q1375854021/AD9854_Driver_Board_BlueTooth/Firmware/Core/Src/main.c

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
/* Includes ------------------------------------------------------------------*/
#include "main.h"
#include "tim.h"
#include "usart.h"
#include "gpio.h"

/* USER CODE BEGIN Includes */
#include "Led.h"
#include "Usart1.h"
#include "AD9854.h"

/* USER CODE END Includes */


void SystemClock_Config(void);
/**
  * @brief  The application entry point.
  * @retval int
  */
int main(void)
{
  /* USER CODE BEGIN 1 */
	struct Uart_Data_Struc Uart_Data_AD9854;
  /* USER CODE END 1 */

  /* MCU Configuration--------------------------------------------------------*/

  /* Reset of all peripherals, Initializes the Flash interface and the Systick. */
  LL_APB2_GRP1_EnableClock(LL_APB2_GRP1_PERIPH_AFIO);
  LL_APB1_GRP1_EnableClock(LL_APB1_GRP1_PERIPH_PWR);

  /* System interrupt init*/
  NVIC_SetPriorityGrouping(NVIC_PRIORITYGROUP_2);

  /* SysTick_IRQn interrupt configuration */
  NVIC_SetPriority(SysTick_IRQn, NVIC_EncodePriority(NVIC_GetPriorityGrouping(),1, 1));

  /** NOJTAG: JTAG-DP Disabled and SW-DP Enabled
  */
  LL_GPIO_AF_Remap_SWJ_NOJTAG();

  /* Configure the system clock */
  SystemClock_Config();

  /* Initialize all configured peripherals */
  MX_GPIO_Init();
  MX_TIM1_Init();
  MX_USART1_UART_Init();
  /* USER CODE BEGIN 2 */
	AD9854_Init();                //AD9854配置初始化
	AD9854_SetSine(1000000,4095);      //默认输出1MHz满幅正弦波
  /* USER CODE END 2 */

  /* Infinite loop */
  /* USER CODE BEGIN WHILE */
  while (1)
  {
		if(AD9854_Uartdata_Analysis(&Uart_Data_AD9854)!=0)           //AD9854的串口接收数据提取
		{
			USART1_Printf("Error\r\n");
		}
		USART1_Recv_DataArray_Clear();                          //清空串口缓冲区数据
		AD9854_Cmd_Execute(&Uart_Data_AD9854);                  //根据接收到的数据执行对应命令
		LED_Toggle();
		LL_mDelay(1000);
    /* USER CODE END WHILE */

    /* USER CODE BEGIN 3 */
  }
  /* USER CODE END 3 */
}

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
