q1375854021/AD9854_Driver_Board_BlueTooth/Firmware/Core/Inc/main.h

#define LED_Pin LL_GPIO_PIN_13
#define LED_GPIO_Port GPIOC
#define AD9854_RD_Pin LL_GPIO_PIN_0
#define AD9854_RD_GPIO_Port GPIOB
#define AD9854_OSK_Pin LL_GPIO_PIN_1
#define AD9854_OSK_GPIO_Port GPIOB
#define AD9854_FSK_Pin LL_GPIO_PIN_11
#define AD9854_FSK_GPIO_Port GPIOB
#define AD9854_RST_Pin LL_GPIO_PIN_11
#define AD9854_RST_GPIO_Port GPIOA
#define AD9854_UCLK_Pin LL_GPIO_PIN_12
#define AD9854_UCLK_GPIO_Port GPIOA
#define AD9854_WR_Pin LL_GPIO_PIN_15
#define AD9854_WR_GPIO_Port GPIOA
#define NVIC_PRIORITYGROUP_0         ((uint32_t)0x00000007) /*!< 0 bit  for pre-emption priority,
#define NVIC_PRIORITYGROUP_1         ((uint32_t)0x00000006) /*!< 1 bit  for pre-emption priority,
#define NVIC_PRIORITYGROUP_2         ((uint32_t)0x00000005) /*!< 2 bits for pre-emption priority,
#define NVIC_PRIORITYGROUP_3         ((uint32_t)0x00000004) /*!< 3 bits for pre-emption priority,
#define NVIC_PRIORITYGROUP_4         ((uint32_t)0x00000003) /*!< 4 bits for pre-emption priority,
