q1375854021/AD9854_Driver_Board_BlueTooth/Firmware/Core/Src/AD9854.c

//=====================================================================
//                    AD9854 驱动程序设计

//AD9854.c
//康威电子工作室
//说明：本程序基于硬件的外接晶振为20MHZ
//=====================================================================

#include "AD9854.h"      //STC单片机头文件	
#include "Usart1.h"


uchar FreqWord[6];				 //6个字节频率控制字

//**********************以下为系统时钟以及其相关变量设置**************************

/* 
      此处根据自己的需要设置系统时钟以及与其相关的因子，一次需且只需开启一个   
      CLK_Set为时钟倍频设置，可设置4~20倍倍频，但最大不能超过300MHZ
      Freq_mult_ulong和Freq_mult_doulle均为2的48次方除以系统时钟，一个为长整形，一个为双精度型
*/

/*
#define      CLK_Set            4
const ulong  Freq_mult_ulong  = 3518437;
const double Freq_mult_doulle = 3518437.2088832;
*/

/*
#define      CLK_Set            5
const ulong  Freq_mult_ulong  = 2814750;
const double Freq_mult_doulle = 2814749.76710656;
*/

 /*
#define      CLK_Set            6
const ulong  Freq_mult_ulong  = 2345625;
const double Freq_mult_doulle = 2345624.80592213;
  */

/*
#define      CLK_Set            7
const ulong  Freq_mult_ulong  = 2010536;
const double Freq_mult_doulle = 2010535.54793326;
*/

/*
#define      CLK_Set            8
const ulong  Freq_mult_ulong  = 1759219;
const double Freq_mult_doulle = 1759218.6044416;
*/

/*
#define      CLK_Set            9
const ulong  Freq_mult_ulong  = 1563750;
const double Freq_mult_doulle = 1563749.87061476;
*/

/*
#define      CLK_Set            10
const ulong  Freq_mult_ulong  = 1407375;
const double Freq_mult_doulle = 1407374.88355328;
*/

/*
#define      CLK_Set            11
const ulong  Freq_mult_ulong  = 1279432;
const double Freq_mult_doulle = 1279431.712321164;
*/


#define      CLK_Set            0x4C   //0x0C 
const ulong  Freq_mult_ulong  = 1172812;
const double Freq_mult_doulle = 1172812.402961067;


/*
#define      CLK_Set            13
const ulong  Freq_mult_ulong  = 1082596;
const double Freq_mult_doulle = 1082596.064271754;
*/

/*
#define      CLK_Set            14
const ulong  Freq_mult_ulong  = 1005268;
const double Freq_mult_doulle = 1005267.773966629;
*/

/*
#define      CLK_Set            15
const ulong  Freq_mult_ulong  = 938250;
const double Freq_mult_doulle = 938249.9223688533;

 */
//**************************修改硬件时要修改的部分********************************



//**************************以下部分为函数定义********************************

static void AD9854_WR_Byte(u8 addr,u8 dat);				  
static void Freq_convert(long Freq);	         	  
extern void AD9854_SetSine(ulong Freq,uint Shape);	  
static void Freq_double_convert(double Freq);		  
extern void AD9854_SetSine_double(double Freq,uint Shape);
extern void AD9854_InitFSK(void);				
extern void AD9854_SetFSK(ulong Freq1,ulong Freq2);					  
extern void AD9854_InitBPSK(void);					  
extern void AD9854_SetBPSK(uint Phase1,uint Phase2);					
extern void AD9854_InitOSK(void);					 
extern void AD9854_SetOSK(uchar RateShape);					  
extern void AD9854_InitAM(void);					 
extern void AD9854_SetAM(uint Shape);					
extern void AD9854_InitRFSK(void);					 
extern void AD9854_SetRFSK(ulong Freq_Low,ulong Freq_High,ulong Freq_Up_Down,ulong FreRate);				


//====================================================================================
//函数名称:void AD9854_WR_Byte(uchar addr,uchar dat)
//函数功能:AD9854并行口写入数据
//入口参数:addr     6位地址
//         dat      写入的数据
//出口参数:无
//====================================================================================
	u32 dat1,dat2;

void AD9854_WR_Byte(u8 addr,u8 dat)
{   //为了配置PA0~PA7而不改变其它引脚状态，应当把BSRR的第16~23位置1，从而清零低八位，然后在把第八位重新配置一下就可以了
	AD9854_DataBus |= 0x00FF0000;               //清除PA0~PA7
	AD9854_DataBus |= dat;
	AD9854_AdrBus |= 0x01F80000;                       //清除PB3~PB8    //0000 0001 1111 1000
	AD9854_AdrBus |= addr << 3;                         //低6位  0~5 -> 3~8
	AD9854_WR      = 0;                         //然后WR上给一个脉冲，传送数据到AD9854的Buffer
	AD9854_WR      = 1;
}

//====================================================================================
//函数名称:void AD9854_Init(void)
//函数功能:AD9854初始化
//入口参数:无
//出口参数:无
// 具体初始状态可见AD9854手册的Figure35
//====================================================================================
void AD9854_Init(void)
{
	AD9854_WR=1;                  //将读、写控制端口设为无效
	AD9854_RD=1;
	AD9854_UDCLK=0;
	AD9854_RST=1;                 //复位AD9854
	AD9854_RST=0;

	AD9854_WR_Byte(0x1d,0x00);					//打开比较器供电开关，QDAC供电开关，DAC供电开关，数字供电开关。
	//	AD9854_WR_Byte(0x1d,0x10);	    //关闭比较器
	AD9854_WR_Byte(0x1e,CLK_Set);	   		//设置系统时钟倍频        0C  0000_1100      倍频01100，就是12倍倍频，240MHz，不过已经超过200MHz了，PLL range bit应当为1，也就是应当设置为0100_1100 应当是4C
	AD9854_WR_Byte(0x1f,0x00);	   			//设置系统为模式0，由外部更新     ACC1 AC2 Triangle SRC_QADC都没有用到
	AD9854_WR_Byte(0x20,0x60);	   			//设置为可调节幅度，取消插值补偿     //0110_0000   内部逆sinc滤波器旁路掉了，然后OSK EN设为一，可以控制幅度  最后其实可以做一下逆sinc滤波的

	AD9854_UDCLK=1;               			//更新AD9854输出
	AD9854_UDCLK=0;
}
//====================================================================================
//函数名称:void Freq_convert(long Freq)
//函数功能:正弦信号频率数据转换
//入口参数:Freq   需要转换的频率，取值从0~SYSCLK/2
//出口参数:无   但是影响全局变量FreqWord[6]的值
//说明：   该算法位多字节相乘算法，有公式FTW = (Desired Output Frequency × 2N)/SYSCLK
//         得到该算法，其中N=48，Desired Output Frequency 为所需要的频率，即Freq，SYSCLK
//         为可编程的系统时钟，FTW为48Bit的频率控制字，即FreqWord[6]
//====================================================================================
void Freq_convert(long Freq)   
{
	ulong FreqBuf;
	ulong Temp=Freq_mult_ulong;   	       

	uchar Array_Freq[4];			     //将输入频率因子分为四个字节
	Array_Freq[0]=(uchar)Freq;
	Array_Freq[1]=(uchar)(Freq>>8);
	Array_Freq[2]=(uchar)(Freq>>16);
	Array_Freq[3]=(uchar)(Freq>>24);

	FreqBuf=Temp*Array_Freq[0];                  
	FreqWord[0]=FreqBuf;    
	FreqBuf>>=8;

	FreqBuf+=(Temp*Array_Freq[1]);
	FreqWord[1]=FreqBuf;
	FreqBuf>>=8;

	FreqBuf+=(Temp*Array_Freq[2]);
	FreqWord[2]=FreqBuf;
	FreqBuf>>=8;

	FreqBuf+=(Temp*Array_Freq[3]);
	FreqWord[3]=FreqBuf;
	FreqBuf>>=8;

	FreqWord[4]=FreqBuf;
  FreqWord[5]=FreqBuf>>8;			
}  

//====================================================================================
//函数名称:void AD9854_SetSine(ulong Freq,uint Shape)
//函数功能:AD9854正弦波产生程序
//入口参数:Freq   频率设置，取值范围为0~(1/2)*SYSCLK
//         Shape  幅度设置. 为12 Bit,取值范围为(0~4095) ,取值越大,幅度越大 
//出口参数:无
//====================================================================================
void AD9854_SetSine(ulong Freq,uint Shape)
{
	uchar count;
	uchar Adress;

	Adress = 0x04;                        //选择频率控制字地址的初值

	Freq_convert(Freq);		           //频率转换

	for(count=6;count>0;)	          //写入6字节的频率控制字  
	{
		AD9854_WR_Byte(Adress++,FreqWord[--count]);   //写入频率FTW1
	}

	AD9854_WR_Byte(0x21,Shape>>8);	  //设置I通道幅度
	AD9854_WR_Byte(0x22,(uchar)(Shape&0xff));

	AD9854_WR_Byte(0x23,Shape>>8);	  //设置Q通道幅度
	AD9854_WR_Byte(0x24,(uchar)(Shape&0xff));

	AD9854_UDCLK=1;                    //更新AD9854输出
	AD9854_UDCLK=0;
}

//====================================================================================
//函数名称:void Freq_doublt_convert(double Freq)
//函数功能:正弦信号频率数据转换
//入口参数:Freq   需要转换的频率，取值从0~SYSCLK/2
//出口参数:无   但是影响全局变量FreqWord[6]的值
//说明：   有公式FTW = (Desired Output Frequency × 2N)/SYSCLK得到该函数，
//         其中N=48，Desired Output Frequency 为所需要的频率，即Freq，SYSCLK
//         为可编程的系统时钟，FTW为48Bit的频率控制字，即FreqWord[6]
//注意：   该函数与上面函数的区别为该函数的入口参数为double，可使信号的频率更精确
//         建议在100HZ以下用本函数，在高于100HZ的情况下用函数void Freq_convert(long Freq)
//====================================================================================
void Freq_double_convert(double Freq)   
{
	ulong Low32;
	uint  High16;
	double Temp=Freq_mult_doulle;   	            //23ca99为2的48次方除以120M
	Freq*=(double)(Temp);
	//	1 0000 0000 0000 0000 0000 0000 0000 0000 = 4294967295
	High16 =(int)(Freq/4294967295);                  //2^32 = 4294967295
	Freq -= (double)High16*4294967295;
	Low32 = (ulong)Freq;

	FreqWord[0]=Low32;	     
	FreqWord[1]=Low32>>8;
	FreqWord[2]=Low32>>16;
	FreqWord[3]=Low32>>24;
	FreqWord[4]=High16;
	FreqWord[5]=High16>>8;			
} 
//====================================================================================
//函数名称:void AD9854_SetSine_double(double Freq,uint Shape)
//函数功能:AD9854正弦波产生程序
//入口参数:Freq   频率设置，取值范围为0~1/2*SYSCLK
//         Shape  幅度设置. 为12 Bit,取值范围为(0~4095) 
//出口参数:无
//====================================================================================
void AD9854_SetSine_double(double Freq,uint Shape)
{
	uchar count=0;
	uchar Adress;

	Adress=0x04;						     //选择频率控制字1地址的初值

	Freq_double_convert(Freq);		           //频率转换

	for(count=6;count>0;)	                    //写入6字节的频率控制字  
	{
		AD9854_WR_Byte(Adress++,FreqWord[--count]);
	}

	AD9854_WR_Byte(0x21,Shape>>8);	  //设置I通道幅度
	AD9854_WR_Byte(0x22,(uchar)(Shape&0xff));

	AD9854_WR_Byte(0x23,Shape>>8);	  //设置Q通道幅度
	AD9854_WR_Byte(0x24,(uchar)(Shape&0xff));

	AD9854_UDCLK=1;                    //更新AD9854输出
	AD9854_UDCLK=0;
}

//====================================================================================
//函数名称:void AD9854_InitFSK(void)
//函数功能:AD9854的FSK初始化
//入口参数:无
//出口参数:无
// 仅仅是初始化了FSK而已，还没有配置FSK的FTW1和FTW2。
//====================================================================================
void AD9854_InitFSK(void)
{
	AD9854_WR=1;                        //将读、写控制端口设为无效
	AD9854_RD=1;
	AD9854_UDCLK=0;
	AD9854_RST=1;                        //复位AD9854
	AD9854_RST=0;	

	AD9854_WR_Byte(0x1d,0x00);	       //打开比较器   
	AD9854_WR_Byte(0x1e,CLK_Set);	   //设置系统时钟倍频  
	AD9854_WR_Byte(0x1f,0x02);	       //设置系统为模式1，由外部更新   
	AD9854_WR_Byte(0x20,0x60);	      //设置为可调节幅度，取消插值补偿  

	AD9854_UDCLK=1;                  //更新AD9854输出
	AD9854_UDCLK=0;
}

//====================================================================================
//函数名称:void AD9854_SetFSK(ulong Freq1,ulong Freq2)
//函数功能:AD9854的FSK设置
//入口参数:Freq1   FSK频率1
//         Freq2   FSK频率2
//出口参数:无
// 这里Freq1必须小于Freq2
//====================================================================================
void AD9854_SetFSK(ulong Freq1,ulong Freq2)
{
	uchar count=6;
	uchar Adress1,Adress2;

	const uint Shape=4000;	      //幅度设置. 为12 Bit,取值范围为(0~4095)

	Adress1=0x04;				 //选择频率控制字1地址的初值
	Adress2=0x0a;				 //选择频率控制字2地址的初值

	Freq_convert(Freq1);               //频率转换1

	for(count=6;count>0;)	          //写入6字节的频率控制字  
	{
		AD9854_WR_Byte(Adress1++,FreqWord[--count]);
	}

	Freq_convert(Freq2);               //频率转换2

	for(count=6;count>0;)	          //写入6字节的频率控制字  
	{
		AD9854_WR_Byte(Adress2++,FreqWord[--count]);
	}

	AD9854_WR_Byte(0x21,Shape>>8);	      //设置I通道幅度
	AD9854_WR_Byte(0x22,(uchar)(Shape&0xff));

	AD9854_WR_Byte(0x23,Shape>>8);	     //设置Q通道幅度
	AD9854_WR_Byte(0x24,(uchar)(Shape&0xff));

	AD9854_UDCLK=1;                    //更新AD9854输出
	AD9854_UDCLK=0;		
}

//====================================================================================
//函数名称:void AD9854_InitBPSK(void)
//函数功能:AD9854的BPSK初始化
//入口参数:无
//出口参数:无
//====================================================================================
void AD9854_InitBPSK(void)
{
	AD9854_WR=1;                    //将读、写控制端口设为无效
	AD9854_RD=1;
	AD9854_UDCLK=0;
	AD9854_RST=1;                   //复位AD9854
	AD9854_RST=0;

	AD9854_WR_Byte(0x1d,0x00);	       //打开比较器，输出方波
	AD9854_WR_Byte(0x1e,CLK_Set);	   //设置系统时钟倍频
	AD9854_WR_Byte(0x1f,0x08);	      //设置系统为模式4，由外部更新
	AD9854_WR_Byte(0x20,0x60);	      //设置为可调节幅度，取消插值补偿

	AD9854_UDCLK=1;                //更新AD9854输出
	AD9854_UDCLK=0;
}

//====================================================================================
//函数名称:void AD9854_SetBPSK(uint Phase1,uint Phase2)
//函数功能:AD9854的BPSK设置
//入口参数:Phase1   调制相位1
//         Phase2	调制相位2
//出口参数:无
//说明：   相位为14Bit，取值从0~16383，建议在用本函数的时候将Phase1设置为0，
//         将Phase1设置为8192，180°相位
//====================================================================================
void AD9854_SetBPSK(uint Phase1,uint Phase2)
{
	uchar count;

	const ulong Freq=60000;
	const uint Shape=4000;

	uchar Adress;
	Adress=0x04;                           //选择频率控制字1地址的初值

	AD9854_WR_Byte(0x00,Phase1>>8);	           //设置相位1
	AD9854_WR_Byte(0x01,(uchar)(Phase1&0xff));

	AD9854_WR_Byte(0x02,Phase2>>8);	          //设置相位2
	AD9854_WR_Byte(0x03,(uchar)(Phase2&0xff));

	Freq_convert(Freq);                            //频率转换

	for(count=6;count>0;)	                         //写入6字节的频率控制字  
	{
		AD9854_WR_Byte(Adress++,FreqWord[--count]);
	}

	AD9854_WR_Byte(0x21,Shape>>8);	                  //设置I通道幅度
	AD9854_WR_Byte(0x22,(uchar)(Shape&0xff));

	AD9854_WR_Byte(0x23,Shape>>8);	               //设置Q通道幅度
	AD9854_WR_Byte(0x24,(uchar)(Shape&0xff));

	AD9854_UDCLK=1;                                //更新AD9854输出
	AD9854_UDCLK=0;	
}

//====================================================================================
//函数名称:void AD9854_InitOSK(void)
//函数功能:AD9854的OSK初始化
//入口参数:无
//出口参数:无
//====================================================================================
void AD9854_InitOSK(void)
{
	AD9854_WR=1;                           //将读、写控制端口设为无效
	AD9854_RD=1;
	AD9854_UDCLK=0;
	AD9854_RST=1;                          //复位AD9854
	AD9854_RST=0;

	AD9854_WR_Byte(0x1d,0x00);	           //打开比较器
	AD9854_WR_Byte(0x1e,CLK_Set);	       //设置系统时钟倍频
	AD9854_WR_Byte(0x1f,0x00);	           //设置系统为模式0，由外部更新
	AD9854_WR_Byte(0x20,0x70);	           //设置为可调节幅度，取消插值补偿,通断整形内部控制    0111_0000   OSK斜率内部整形，如果设置为0110_0000，那么就是用I路通道和Q路通道来控制了  。。不过设置成AM模式了

	AD9854_UDCLK=1;                        //更新AD9854输出
	AD9854_UDCLK=0;
}

//====================================================================================
//函数名称:void AD9854_SetOSK(uchar RateShape)
//函数功能:AD9854的OSK设置
//入口参数: RateShape    OSK斜率,取值为4~255，小于4则无效
//出口参数:无
//主要是配置OSK EN bit和OSK INT
//====================================================================================
void AD9854_SetOSK(uchar RateShape)
{
	uchar count;

	const ulong Freq=60000;			 //设置载频
	const uint  Shape=4000;			//幅度设置. 为12 Bit,取值范围为(0~4095)

	uchar Adress;
	Adress=0x04;               //选择频率控制字地址的初值

	Freq_convert(Freq);                       //频率转换

	for(count=6;count>0;)	                         //写入6字节的频率控制字  
	{
		AD9854_WR_Byte(Adress++,FreqWord[--count]);
	}

	AD9854_WR_Byte(0x21,Shape>>8);	                  //设置I通道幅度
	AD9854_WR_Byte(0x22,(uchar)(Shape&0xff));

	AD9854_WR_Byte(0x23,Shape>>8);	                  //设置Q通道幅度
	AD9854_WR_Byte(0x24,(uchar)(Shape&0xff));  	 


	AD9854_WR_Byte(0x25,RateShape);				       //设置OSK斜率

	AD9854_UDCLK=1;                                //更新AD9854输出
	AD9854_UDCLK=0;	
}

//====================================================================================
//函数名称:void AD9854_InitAM(void)
//函数功能:AD9854的AM初始化
//入口参数:无
//出口参数:无
//不能完全称为AM模式，包络只能是方波，幅度还是自己配置的
//====================================================================================
void AD9854_InitAM(void)
{
	uchar count;

	const ulong Freq=60000;			 //设置载频

	uchar  Adress;
	Adress=0x04;      //选择频率控制字地址的初值

	AD9854_WR=1;    //将读、写控制端口设为无效
	AD9854_RD=1;
	AD9854_UDCLK=0;
	AD9854_RST=1;     //复位AD9854
	AD9854_RST=0;

	AD9854_WR_Byte(0x1d,0x00);	                  //打开比较器
	AD9854_WR_Byte(0x1e,CLK_Set);	             //设置系统时钟倍频
	AD9854_WR_Byte(0x1f,0x00);	                 //设置系统为模式0，由外部更新
	AD9854_WR_Byte(0x20,0x60);	                  //设置为可调节幅度，取消插值补偿

	Freq_convert(Freq);                            //频率转换

	for(count=6;count>0;)	                         //写入6字节的频率控制字  
	{
		AD9854_WR_Byte(Adress++,FreqWord[--count]);
	}

	AD9854_UDCLK=1;                             //更新AD9854输出
	AD9854_UDCLK=0;
}

//====================================================================================
//函数名称:void AD9854_SetAM(uchar Shape)
//函数功能:AD9854的AM设置
//入口参数:Shape   12Bit幅度,取值从0~4095   
//出口参数:无
//====================================================================================
void AD9854_SetAM(uint Shape)
{
	AD9854_WR_Byte(0x21,Shape>>8);	                  //设置I通道幅度
	AD9854_WR_Byte(0x22,(uchar)(Shape&0xff));

	AD9854_WR_Byte(0x23,Shape>>8);	                  //设置Q通道幅度
	AD9854_WR_Byte(0x24,(uchar)(Shape&0xff));

	AD9854_UDCLK=1;                                   //更新AD9854输出
	AD9854_UDCLK=0;			
}

//====================================================================================
//函数名称:void AD9854_InitRFSK(void)
//函数功能:AD9854的RFSK初始化
//入口参数:无
//出口参数:无
//斜率FSK模式，还开启了Triange，就是双斜率chirp，频率由低变高，再由高变低，只是这里和FSK引脚没有什么关系了
//====================================================================================
void AD9854_InitRFSK(void)
{
	AD9854_WR=1;                      //将读、写控制端口设为无效
	AD9854_RD=1;
	AD9854_UDCLK=0;
	AD9854_RST=1;                     //复位AD9854
	AD9854_RST=0;

	AD9854_WR_Byte(0x1d,0x00);	       //打开比较器
	AD9854_WR_Byte(0x1e,CLK_Set);	   //设置系统时钟倍频
	AD9854_WR_Byte(0x1f,0x24);	        //设置系统为模式2，由外部更新,使能三角波扫频功能   0010_0100  Triangle使能，010模式。
	AD9854_WR_Byte(0x20,0x60);	        //设置为可调节幅度，取消插值补偿	

	AD9854_UDCLK=1;                   //更新AD9854输出
	AD9854_UDCLK=0;
}

//====================================================================================
//函数名称:void AD9854_SetRFSK(void)
//函数功能:AD9854的RFSK设置
//入口参数:Freq_Low          RFSK低频率	   48Bit
//         Freq_High         RFSK高频率	   48Bit
//         Freq_Up_Down		 步进频率	   48Bit
//		   FreRate           斜率时钟控制  20Bit
//出口参数:无
//注：     每两个脉冲之间的时间周期用下式表示（FreRate +1）*（System Clock ），一个脉冲,
//         频率 上升或者下降 一个步进频率
//   比如系统时钟300MHz，那么一秒输出300M个Sample，如果FreRate是1，一秒输出仍然是300M个Sample，如果是2，那么只输出150M个Sample
//====================================================================================
void AD9854_SetRFSK(ulong Freq_Low,ulong Freq_High,ulong Freq_Up_Down,ulong FreRate)
{
	uchar count=6;
	uchar Adress1,Adress2,Adress3;
	const uint  Shape=4000;			   //幅度设置. 为12 Bit,取值范围为(0~4095)

	Adress1=0x04;		     //选择频率控制字地址的初值 
	Adress2=0x0a;
	Adress3=0x10;

	Freq_convert(Freq_Low);                             //频率1转换

	for(count=6;count>0;)	                         //写入6字节的频率控制字  
	{
		AD9854_WR_Byte(Adress1++,FreqWord[--count]);
	}

	Freq_convert(Freq_High);                             //频率2转换

	for(count=6;count>0;)	                         //写入6字节的频率控制字  
	{
		AD9854_WR_Byte(Adress2++,FreqWord[--count]);
	}

	Freq_convert(Freq_Up_Down);                             //步进频率转换

	for(count=6;count>0;)	                               //写入6字节的频率控制字  
	{
		AD9854_WR_Byte(Adress3++,FreqWord[--count]);
	}

	// 设置的Ramp Rate Clock，20个bit
	AD9854_WR_Byte(0x1a,(uchar)((FreRate>>16)&0x0f));				   //设置斜升速率
	AD9854_WR_Byte(0x1b,(uchar)(FreRate>>8));
	AD9854_WR_Byte(0x1c,(uchar)FreRate);				    

	AD9854_WR_Byte(0x21,Shape>>8);	                  //设置I通道幅度
	AD9854_WR_Byte(0x22,(uchar)(Shape&0xff));

	AD9854_WR_Byte(0x23,Shape>>8);	                  //设置Q通道幅度
	AD9854_WR_Byte(0x24,(uchar)(Shape&0xff));

	AD9854_UDCLK=1;                                //更新AD9854输出
	AD9854_UDCLK=0;	
}

uint8_t AD9854_Uartdata_Analysis(struct Uart_Data_Struc *uart_data_struc)
{
	uint8_t current_index=0;                        //用于标志目前读取的串口位置
	uint8_t temp_i=0;                               //用于For循环
	memset(uart_data_struc,0,sizeof(*uart_data_struc));        //清零结构体，防止移位赋值的时候出现问题
	if(USART1_Data_Recv[current_index]==0x00)             //没有收到数据
		return 0;               
	else if(USART1_Data_Recv[current_index]!=0x55)        //收到数据但不是0x55
		return 1;    //协议头出错
	else ;
	current_index++;         //第1部分   命令
	uart_data_struc->cmd = USART1_Data_Recv[current_index];    // 把cmd存起来
	current_index++;        //第2部分，到数据部分了
	
	switch( uart_data_struc->cmd)       //根据cmd决定吧数据给谁赋值
	{
		// 命令1   单频率输出
		case (0x01):
			for(temp_i=0;temp_i<4;temp_i++)          //数据1 4个byte  频率1  1-150MHz   48bit
			{
				uart_data_struc->Data1.Freq1 = ( (uart_data_struc->Data1.Freq1)| USART1_Data_Recv[current_index]<<8*(4-1-temp_i));
				current_index++;
			}
			for(temp_i=0;temp_i<2;temp_i++)         //数据2 2个byte  幅度 1-4095    12bit
			{
				uart_data_struc->Data2.Amplitude = ( (uart_data_struc->Data2.Amplitude)| USART1_Data_Recv[current_index]<<8*(2-1-temp_i));
				current_index++;
			}
			if(USART1_Data_Recv[current_index]!=0xCC)
				return 2;                       //数据尾出错
			break;

		// 命令2   FSK输出
		case 0x02:
			for(temp_i=0;temp_i<4;temp_i++)          //数据1 4个byte  频率1  1-150MHz   48bit
			{
				uart_data_struc->Data1.Freq1 = ( (uart_data_struc->Data1.Freq1)| USART1_Data_Recv[current_index]<<8*(4-1-temp_i));
				current_index++;
			}
			for(temp_i=0;temp_i<4;temp_i++)          //数据1 4个byte  频率1  1-150MHz   48bit
			{
				uart_data_struc->Data2.Freq2 = ( (uart_data_struc->Data2.Freq2)| USART1_Data_Recv[current_index]<<8*(4-1-temp_i));
				current_index++;
			}
			if(USART1_Data_Recv[current_index]!=0xCC)
				return 2;                       //数据尾出错
			break;

		// 命令3   BPSK输出
		case 0x03:
			for(temp_i=0;temp_i<2;temp_i++)          //数据1 2个byte   相位1   1-16383  14bit
			{
				uart_data_struc->Data1.Phase1 = ( (uart_data_struc->Data1.Phase1)| USART1_Data_Recv[current_index]<<8*(2-1-temp_i));
				current_index++;
			}
			for(temp_i=0;temp_i<2;temp_i++)         //数据2 2个byte      相位2   1-16383   14bit
			{
				uart_data_struc->Data2.Phase2 = ( (uart_data_struc->Data2.Phase2)| USART1_Data_Recv[current_index]<<8*(2-1-temp_i));
				current_index++;
			}
			if(USART1_Data_Recv[current_index]!=0xCC)
				return 2;                       //数据尾出错
			break;

		// 命令4   OSK输出
		case 0x04:
			for(temp_i=0;temp_i<1;temp_i++)          //数据1 1个byte   OSK斜率  0-255  8bit
			{
				uart_data_struc->Data1.OSK_Slop = ( (uart_data_struc->Data1.OSK_Slop)| USART1_Data_Recv[current_index]<<8*(1-1-temp_i));
				current_index++;
			}
			if(USART1_Data_Recv[current_index]!=0xCC)
				return 2;                       //数据尾出错
			break;

		// 命令5   AM输出
		case 0x05:
			for(temp_i=0;temp_i<2;temp_i++)          //数据1 2个byte    幅度   1-4095  12bit
			{
				uart_data_struc->Data1.AM_Amplitude = ( (uart_data_struc->Data1.AM_Amplitude)| USART1_Data_Recv[current_index]<<8*(2-1-temp_i));
				current_index++;
			}
			if(USART1_Data_Recv[current_index]!=0xCC)
				return 2;                       //数据尾出错
			break;

		// 命令6   RFSK输出
		case 0x06:
			for(temp_i=0;temp_i<4;temp_i++)          //数据1 4个byte    低频率  1-150MHz   48bit
			{
				uart_data_struc->Data1.Freq_Low = ( (uart_data_struc->Data1.Freq_Low)| USART1_Data_Recv[current_index]<<8*(4-1-temp_i));
				current_index++;
			}
			for(temp_i=0;temp_i<4;temp_i++)         //数据2 4个byte     高频率  1-150MHz   48bit
			{
				uart_data_struc->Data2.Freq_High = ( (uart_data_struc->Data2.Freq_High)| USART1_Data_Recv[current_index]<<8*(4-1-temp_i));
				current_index++;
			}
			for(temp_i=0;temp_i<4;temp_i++)         //数据3 4个byte     步进频率   1-150MHz   48bit
			{
				uart_data_struc->StepFreq = ( (uart_data_struc->StepFreq)| USART1_Data_Recv[current_index]<<8*(4-1-temp_i));
				current_index++;
			}
			for(temp_i=0;temp_i<3;temp_i++)         //数据4 3个byte   频率时钟控制  20bit
			{
				uart_data_struc->Clock_Freq_Control = ( (uart_data_struc->Clock_Freq_Control)| USART1_Data_Recv[current_index]<<8*(3-1-temp_i));
				current_index++;
			}
			if(USART1_Data_Recv[current_index]!=0xCC)
				return 2;                       //数据尾出错
			break;

		default:return 0;
	}
	return 0;
}


void AD9854_Cmd_Execute(struct Uart_Data_Struc *uart_data_struc)
{
	switch(uart_data_struc->cmd)
	{
		case 0x01:
			AD9854_SetSine(uart_data_struc->Data1.Freq1,uart_data_struc->Data2.Amplitude); 
			break;
		case 0x02:
			AD9854_InitFSK();
			AD9854_SetFSK(uart_data_struc->Data1.Freq1,uart_data_struc->Data2.Freq2);
			break;
		case 0x03:
			AD9854_InitBPSK();
			AD9854_SetBPSK(uart_data_struc->Data1.Phase1,uart_data_struc->Data2.Phase2);
			break;
		case 0x04:
			AD9854_InitOSK();
			AD9854_SetOSK(uart_data_struc->Data1.OSK_Slop);
			break;
		case 0x05:
			AD9854_InitAM();
			AD9854_SetAM(uart_data_struc->Data1.AM_Amplitude);
			break;
		case 0x06:
			AD9854_InitRFSK();
			AD9854_SetRFSK(uart_data_struc->Data1.Freq_Low,uart_data_struc->Data2.Freq_High,uart_data_struc->StepFreq,uart_data_struc->Clock_Freq_Control);
			break;
		default: break;
	}
}
