q1375854021/AD9854_Driver_Board_BlueTooth/(commit log)

2023-08-02 安卓端蓝牙串口App，用于传输相应命令
2023-08-02 创建工程写的一些文档
    [蓝牙通信协议.xlsx]
2023-08-02 STM32单片机程序以及CUBEMX文件
2023-08-02 PCB文件
2023-08-05 修改了部分逻辑
