q1375854021/AD9854_Driver_Board_BlueTooth/(notices)

Notices in the files:
Firmware/Core/Src/main.c:
Copyright (c) 2023 STMicroelectronics.
All rights reserved.
This software is licensed under terms that can be found in the LICENSE file
